pelrun/megaflash/megaflash3d.png

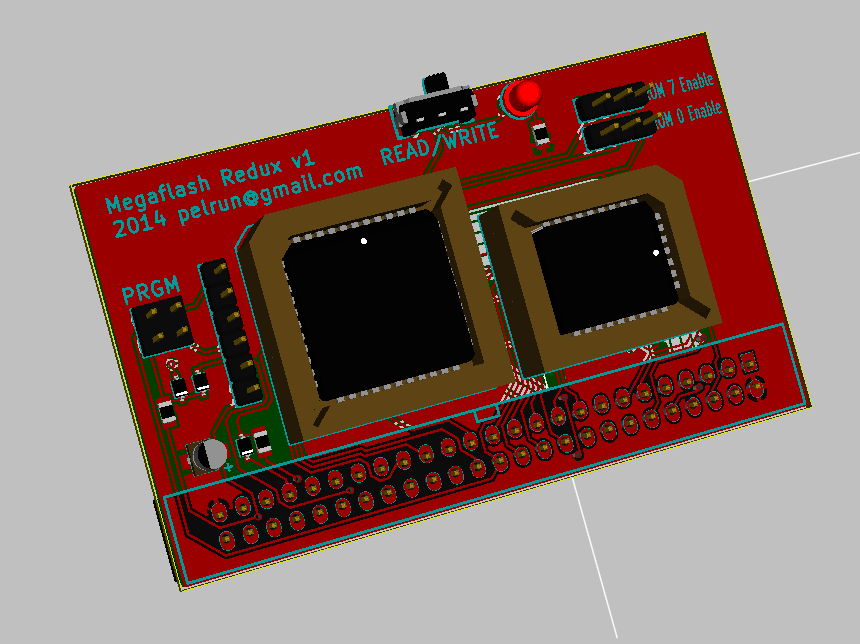
megaflash3d.png
