pelrun/megaflash/megaflash.png

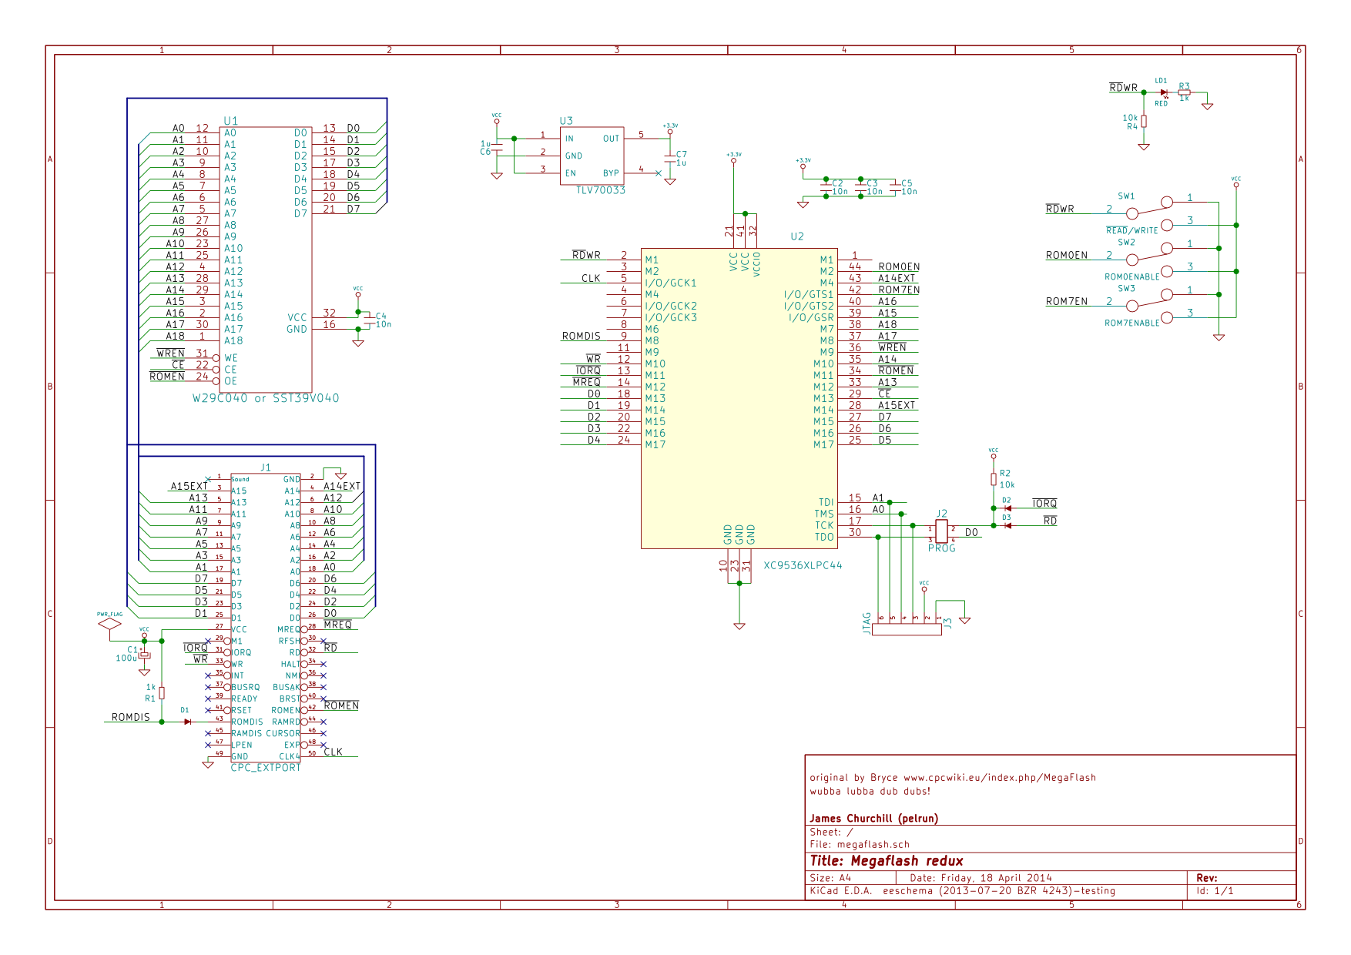
megaflash.png
