pelrun/megaflash/(commit log)

2014-04-17 Initial commit.
    [megaflash.sch]
2014-04-17 Add png ver of schematic
2014-04-19 Nearly finished layout, tweaks/fixes on schematic.
    [megaflash.kicad_pcb, megaflash.sch]
2014-04-19 Fixed scrambled latch inputs. Board mostly routed.
    [megaflash.kicad_pcb, megaflash.sch]
2014-04-22 Completed v1 schematic and layout using XC9536 cpld.
    [megaflash-B_Cu.gbl, megaflash-B_Mask.gbs, megaflash-B_SilkS.gbo, megaflash-Edge_Cuts.gbr, megaflash-F_Cu.gtl, megaflash-F_Mask.gts, megaflash-F_SilkS.gto, megaflash.drl]
2014-04-22 Replaced switch with one that's available from digikey.
    [megaflash-B_Cu.gbl, megaflash-B_Mask.gbs, megaflash-B_SilkS.gbo, megaflash-Edge_Cuts.gbr, megaflash-F_Cu.gtl, megaflash-F_Mask.gts, megaflash-F_SilkS.gto, megaflash.drl]
2014-04-22 Added preliminary BOM
    [megaflash.csv]
2014-04-23 Switch to the 3.3v XC9536XL (since the 5v XC9536 is unavailable)
    [megaflash.csv, megaflash.kicad_pcb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]
